goshi0/pantalla-energia-esphome/README.md

<div align="center">

[English](README.en.md) · **Español**

# ⚡ Pantalla de energía redonda

**Un mini panel de 240×240 px para la casa: consumo eléctrico en tiempo real, coste del día y del mes,
temperaturas de cada habitación… y un Gengar que te da consejos para ahorrar.**






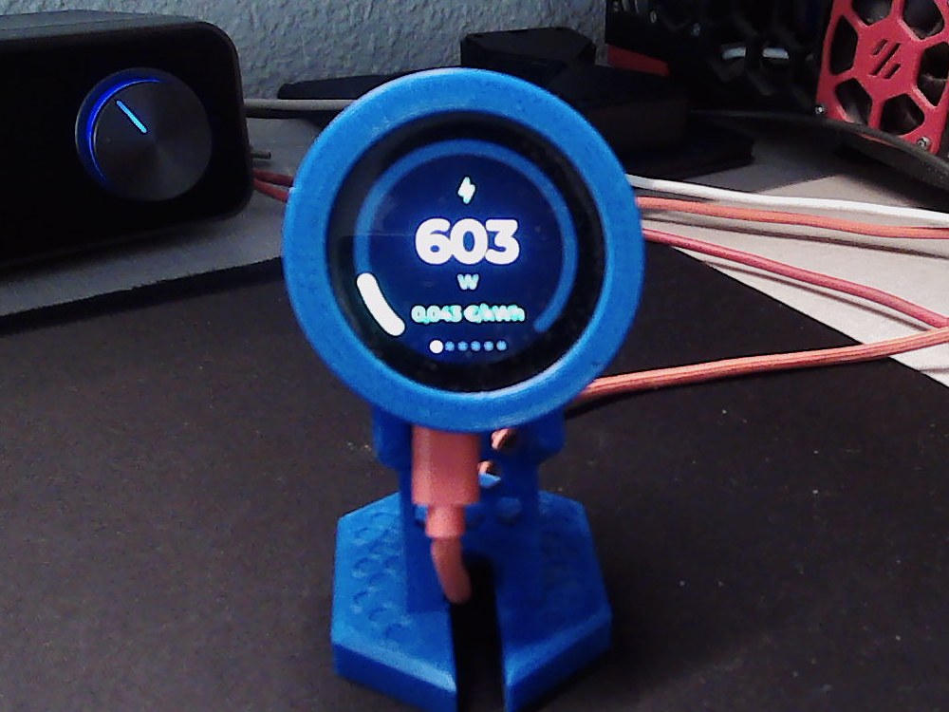
[picture p1: foto-portada.jpg]
La pantalla en su base


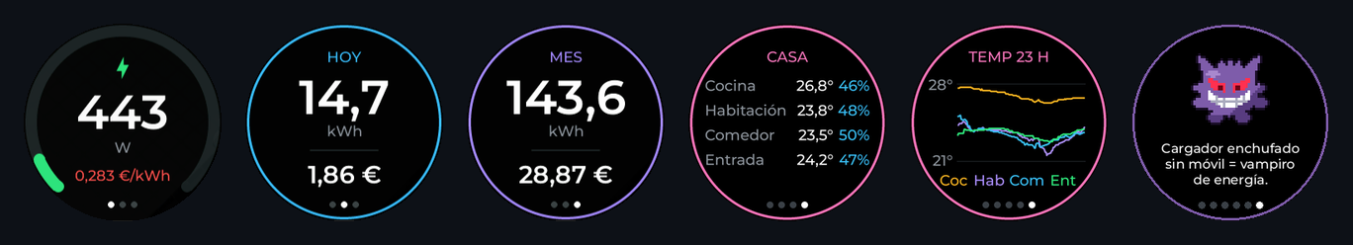
[picture p2: banner.png]
Todas las pantallas


</div>

---

## ✨ Qué hace

- **Potencia al instante** en un arco que pasa de verde a ámbar y a rojo según lo que gastas.
- **Precio PVPC** de la hora actual, coloreado según si es de las horas baratas o caras del día.
- **kWh y € de hoy y del mes**, calculados en el propio dispositivo y guardados en flash para que sobrevivan a un corte.
- **Temperatura y humedad** de cada habitación, más un **gráfico de las últimas 24 h**.
- **Alerta**: si te acercas a la potencia contratada, la pantalla se enciende sola y parpadea en rojo.
- **Gengar** 👻 flota, guiña el ojo, saca la lengua y suelta consejos de ahorro (algunos reaccionan al precio y al consumo del momento).

## 📱 Pantallas

Un **toque** pasa a la siguiente página y un **deslizamiento vertical** gira la pantalla 180° (se recuerda tras reiniciar).
A los 15 s sin tocarla vuelve a la principal.

| | | |
|:---:|:---:|:---:|
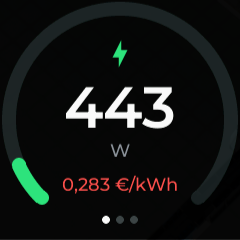
[picture p3: preview-1-ahora.png]
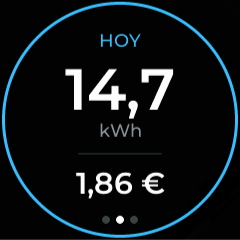
[picture p4: preview-2-hoy.png]
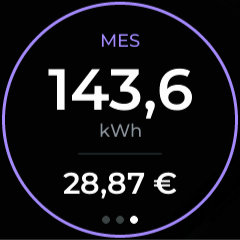
[picture p5: preview-3-mes.png]
| <br>**Ahora**<br>potencia y precio | <br>**Hoy**<br>kWh y € del día | <br>**Mes**<br>kWh y € del mes |
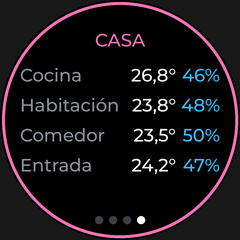
[picture p6: preview-5-casa.png]
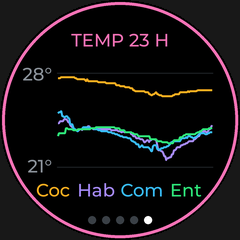
[picture p7: preview-6-grafico.png]
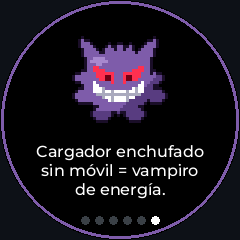
[picture p8: gengar.gif]
| <br>**Casa**<br>temperatura y humedad | <br>**Gráfico**<br>últimas 24 h | <br>**Gengar**<br>consejos con humor |

<details>
<summary>🚨 Modo alerta</summary>
<br>
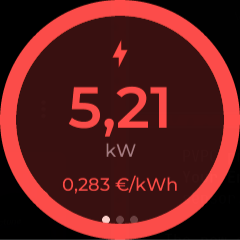
[picture p9: preview-4-alerta.png]


Por encima de `power_alert_on_w` (5000 W) la pantalla se despierta, salta a la página de potencia
y parpadea en rojo hasta que el consumo baja de `power_alert_off_w` (4800 W).
</details>

## 👻 Gengar



Pixel art de 32×32 dibujado a mano (en código) y pintado ×3 en un canvas de LVGL.
Solo se anima mientras su página está visible, así que no gasta CPU el resto del tiempo.

Cada 7 s cambia el consejo. Uno de cada tres depende de lo que pase en ese momento:

- 🟢 precio barato → *«¡Luz barata ahora! Pon la lavadora, ji ji.»*
- 🔴 precio caro → *«¡Luz cara! Deja el horno para luego o te asusto.»*
- ⚡ consumo alto → *«¡Cuánto gastas! Hasta a mí me da miedo.»*

Los consejos están en el script `gengar_tip` de [`pantalla.yaml`](pantalla.yaml). Si añades alguno con
letras nuevas, recuerda incluirlas en los `glyphs` de `font_tip`.

<br clear="right">

## 🔧 Hardware

| Pieza | Detalle |
|---|---|
| Placa | ESP32-C3 (`esp32-c3-devkitm-1`) |
| Pantalla | GC9A01A redonda 240×240, SPI (CLK `GPIO6`, MOSI `GPIO7`, CS `GPIO10`, DC `GPIO2`) |
| Táctil | CST816 por I²C (SDA `4`, SCL `5`, INT `0`, RST `1`) |
| Retroiluminación | PWM en `GPIO3`, controlable desde Home Assistant |

Es la placa **ESP32-2424S012**, la típica «ESP32-C3 round display» de 1,28".

## 🧲 Carcasa y base imprimibles

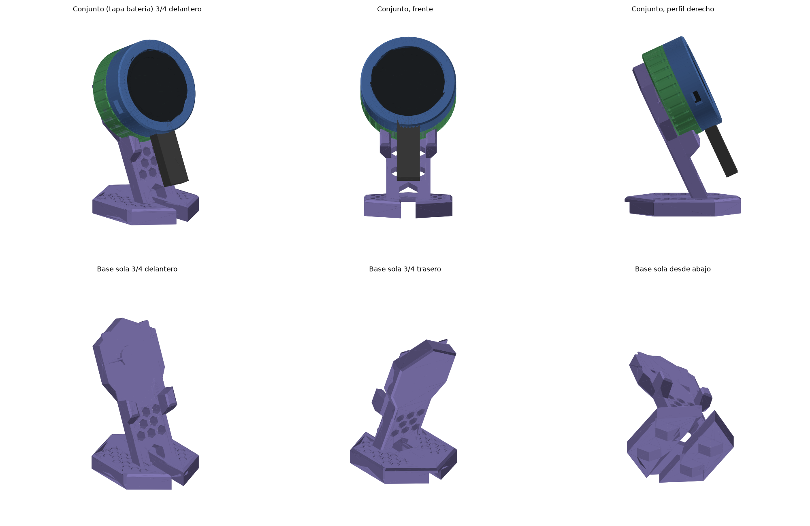
[picture p10: carcasa/img/renders.png]


En [`carcasa/`](carcasa/) tienes una **carcasa redonda imprimible en 3D** con dos tapas roscadas
(solo USB o con batería LiPo) y una **base de carga de estilo industrial** en la que la pantalla
se sujeta con un imán oculto y parece flotar.

- STL listos para imprimir, sin soportes.
- Diseño paramétrico en FreeCAD (Python).
- Instrucciones de impresión, montaje y batería en su [README](carcasa/README.md).

<br clear="right">

## 🛠️ Adáptalo a tu casa

Todo lo que hay que tocar está al principio de [`pantalla.yaml`](pantalla.yaml), en `substitutions`,
organizado por secciones y comentado en inglés y castellano. **No hace falta tocar nada más.**

**B · Energía.** Tus sensores de potencia, energía y precio:

```yaml
entity_power: sensor.mi_medidor_power      # W, al instante
entity_energy: sensor.mi_medidor_energy    # kWh, contador acumulado
entity_price: sensor.esios_pvpc            # €/kWh (integración PVPC)
price_ratio_attribute: price_ratio         # 0 = hora más barata, 1 = la más cara
```

Si tu sensor de precio no tiene `price_ratio`, el precio se muestra en gris y todo lo demás funciona.

**C · Habitaciones.** Nombre, abreviatura para la leyenda del gráfico y sensores:

```yaml
room1_name: "Cocina"
room1_short: "Coc"
room1_temp: sensor.cocina_temperatura
room1_hum: sensor.cocina_humedad
```

¿Tienes menos de cuatro? Busca `[room4]` en el archivo y borra los bloques marcados (después, `[room3]`…).

**D · Umbrales de potencia** según tu potencia contratada:

```yaml
power_green_max_w: "1800"   # verde por debajo
power_amber_max_w: "3600"   # ámbar por debajo, rojo por encima
power_gauge_max_w: "5500"   # fondo de escala
power_alert_on_w:  "5000"   # empieza a parpadear
power_alert_off_w: "4800"   # deja de parpadear
```

**E · Textos y formato.** Los títulos (`HOY`, `MES`, `CASA`…), la moneda y el separador decimal
(`","` o `"."`) se traducen aquí.

**F, H · Comportamiento y colores.** Tiempo de vuelta a la página principal, muestras del gráfico,
velocidad de Gengar y todos los colores (`col_*`).

**I · Primer arranque.** Déjalo a `0` y los contadores empiezan desde la primera lectura. Si quieres
empezar con el día y el mes correctos, pon ahí la lectura del contador.

### Cómo está organizado `pantalla.yaml`

| Sección | Contenido |
|---|---|
| `substitutions` | **Toda tu configuración** (A–I) |
| 1 · Core | Wi-Fi, API, OTA, hora |
| 2 · Hardware | Pantalla, táctil y retroiluminación con sus pines |
| 3 · Datos | Sensores que se leen de Home Assistant |
| 4 · Estado | Contadores guardados en flash y funciones auxiliares |
| 5 · Lógica | Cálculo de kWh y €, alerta, gráfico, animación de Gengar |
| 6 · Fuentes | Tipografías y caracteres incluidos |
| 7 · Interfaz | Las seis páginas en LVGL |

## 🚀 Compilar y flashear

Necesitas un `secrets.yaml` con `wifi_ssid` y `wifi_password`.

**Con ESPHome normal:**

```bash
esphome run pantalla.yaml
```

**A través del add-on ESPHome de Home Assistant** con [`ha.py`](ha.py). Copia [`.env.example`](.env.example)
a `.env` (no se sube al repo) y pon la URL de tu Home Assistant y un token de larga duración:

```bash
uv run --with aiohttp python ha.py put pantalla.yaml pantalla.yaml   # subir la config
uv run --with aiohttp python ha.py validate pantalla.yaml
uv run --with aiohttp python ha.py install pantalla.yaml             # compilar
uv run --with aiohttp python ha.py upload pantalla.yaml              # OTA
uv run --with aiohttp python ha.py logs pantalla.yaml 60             # ver el log
```

> [!TIP]
> Si la OTA falla a medias y el dispositivo reinicia con *brownout*, la fuente USB va justa: reintenta o usa un cargador mejor.
> El firmware anterior sigue intacto.

## 📁 Estructura

```
pantalla.yaml     configuración ESPHome completa en un solo archivo (UI LVGL incluida)
ha.py             cliente del add-on ESPHome de Home Assistant
.env.example      plantilla para la URL y el token de Home Assistant
preview-*.png     capturas de cada página
gengar.gif        animación de la página de Gengar
carcasa/          carcasa y base imprimibles en 3D (STL + fuente FreeCAD)
```

---

<div align="center">
<sub>Gengar es © Nintendo / Game Freak / The Pokémon Company. Proyecto personal sin ánimo de lucro.</sub>
</div>
