goshi0/pantalla-energia-esphome/carcasa/img/imanes.png

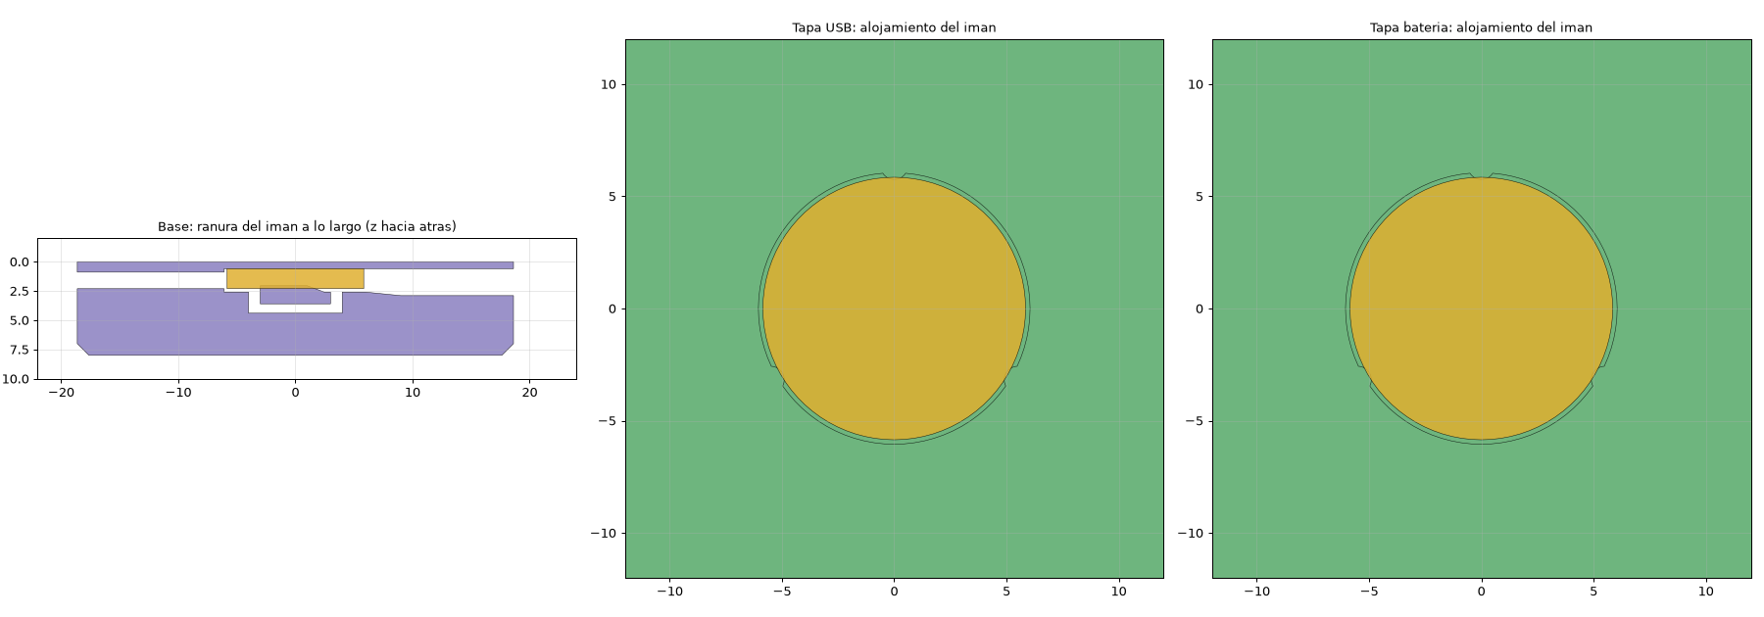
carcasa/img/imanes.png
