goshi0/pantalla-energia-esphome/carcasa/stl/cuerpo.stl

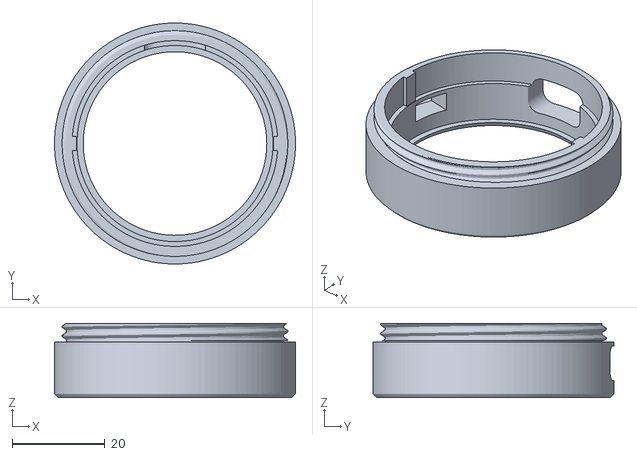
[picture p14: CAD file, 2026-10-25]
carcasa/stl/cuerpo.stl
52.0 x 52.0 x 16.0
