goshi0/pantalla-energia-esphome/carcasa/stl/tapa_usb.stl

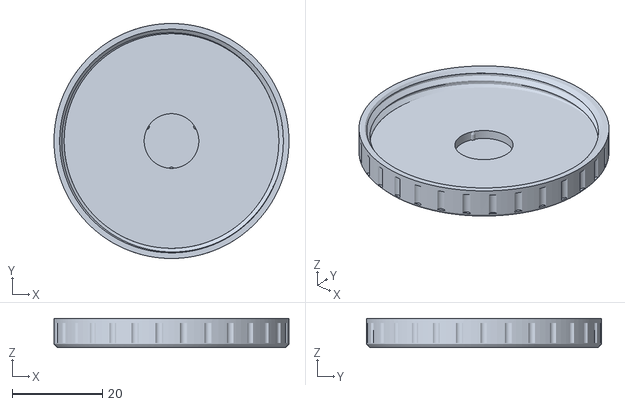
[picture p15: CAD file, 2026-10-25]
carcasa/stl/tapa_usb.stl
52.0 x 52.0 x 6.50
