goshi0/pantalla-energia-esphome/carcasa/stl/tapa_bateria.stl

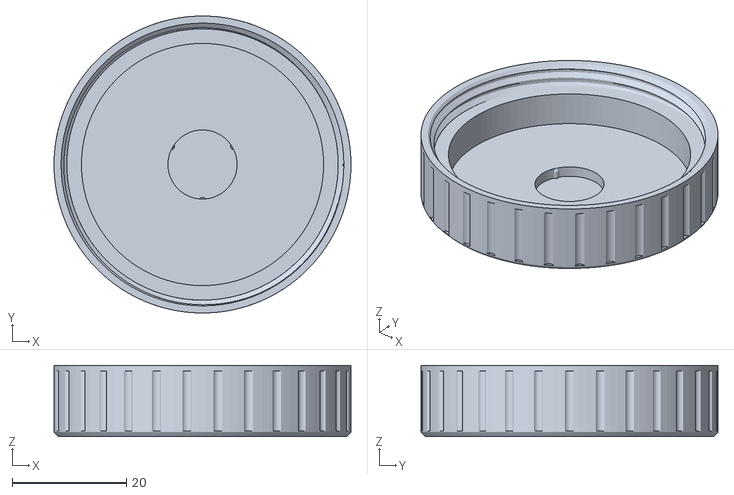
[picture p16: CAD file, 2026-10-25]
carcasa/stl/tapa_bateria.stl
52.0 x 52.0 x 12.5
