goshi0/pantalla-energia-esphome/carcasa/stl/base.stl

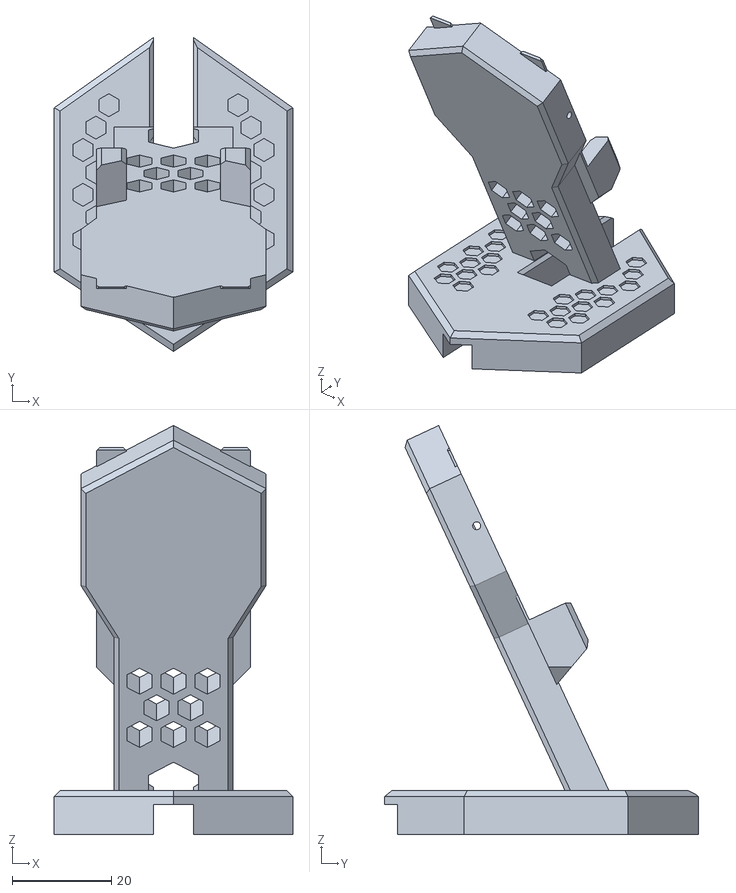
[picture p17: CAD file, 2026-10-25]
carcasa/stl/base.stl
48.0 x 63.2 x 82.2
