goshi0/pantalla-energia-esphome/carcasa/stl/vaso_interior.stl

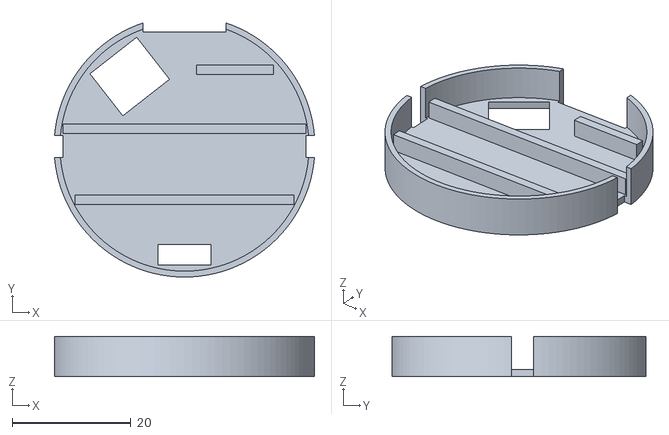
[picture p18: CAD file, 2026-10-25]
carcasa/stl/vaso_interior.stl
43.8 x 42.9 x 6.80
