goshi0/pantalla-energia-esphome/carcasa/stl/probeta_iman_tapa.stl

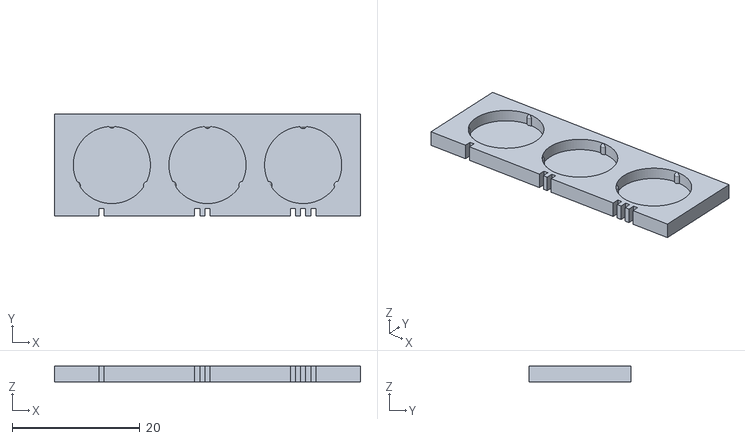
[picture p19: CAD file, 2026-10-25]
carcasa/stl/probeta_iman_tapa.stl
48.0 x 16.0 x 2.50
