goshi0/pantalla-energia-esphome/carcasa/stl/probeta_ranura_iman.stl

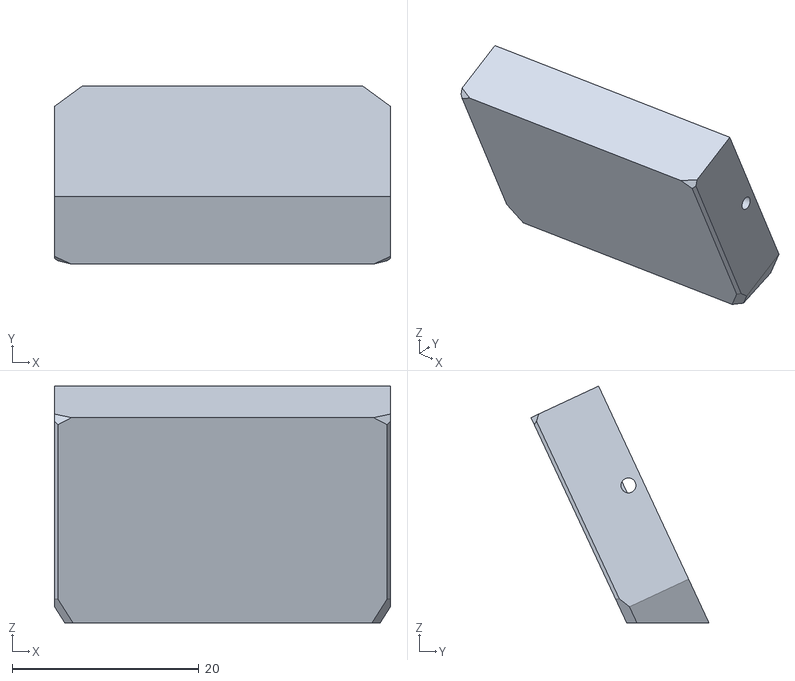
[picture p20: CAD file, 2026-10-25]
carcasa/stl/probeta_ranura_iman.stl
36.0 x 19.1 x 25.4
