goshi0/pantalla-energia-esphome/(commit log)

2026-10-25 Pantalla de energía redonda con ESPHome y LVGL
    Consumo, coste diario y mensual, temperaturas, gráfico de 24 h y
    una página con Gengar animado que da consejos de ahorro.
2026-10-25 Ordena y documenta la configuración para que cualquiera la adapte
    - Todas las entidades de Home Assistant, habitaciones, umbrales, textos y
    colores en substitutions, por secciones (A-I)
    - Comentarios en inglés y castellano en todo el archivo
    - Habitaciones genéricas (room1..room4) marcadas con [roomN] para quitarlas
    - Formateo común (fmt_number, power_color, fmt_temp/fmt_hum) sin repetir lambdas
    - Puntos de página en la capa superior en lugar de copiarlos en cada página
    - Semillas del primer arranque a 0: los contadores empiezan solos
    - ha.py lee HA_URL y HA_TOKEN de .env (añadido .env.example)
2026-10-25 Añade el README en inglés con enlace entre idiomas
2026-10-25 Añade la carcasa imprimible y la base de carga magnética
    STL del diseño elegido (it04), vistas, fuente paramétrica de FreeCAD y
    README en castellano e inglés, enlazados desde el README principal.
    [base.stl, cuerpo.stl, probeta_iman_tapa.stl, probeta_ranura_iman.stl, tapa_bateria.stl, tapa_usb.stl, vaso_interior.stl]
2026-10-25 Añade fotos reales de la pantalla en su base
